Kailer811/r2auto_nav_CDE2310/Mechanical Engineering/Screenshots/6264577846013529998.jpg

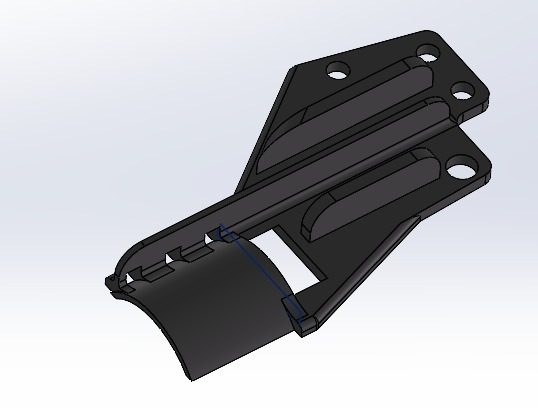
Mechanical Engineering/Screenshots/6264577846013529998.jpg
