Kailer811/r2auto_nav_CDE2310/Electrical Design/Schematic_Diagram_for_Electrical_Design.png

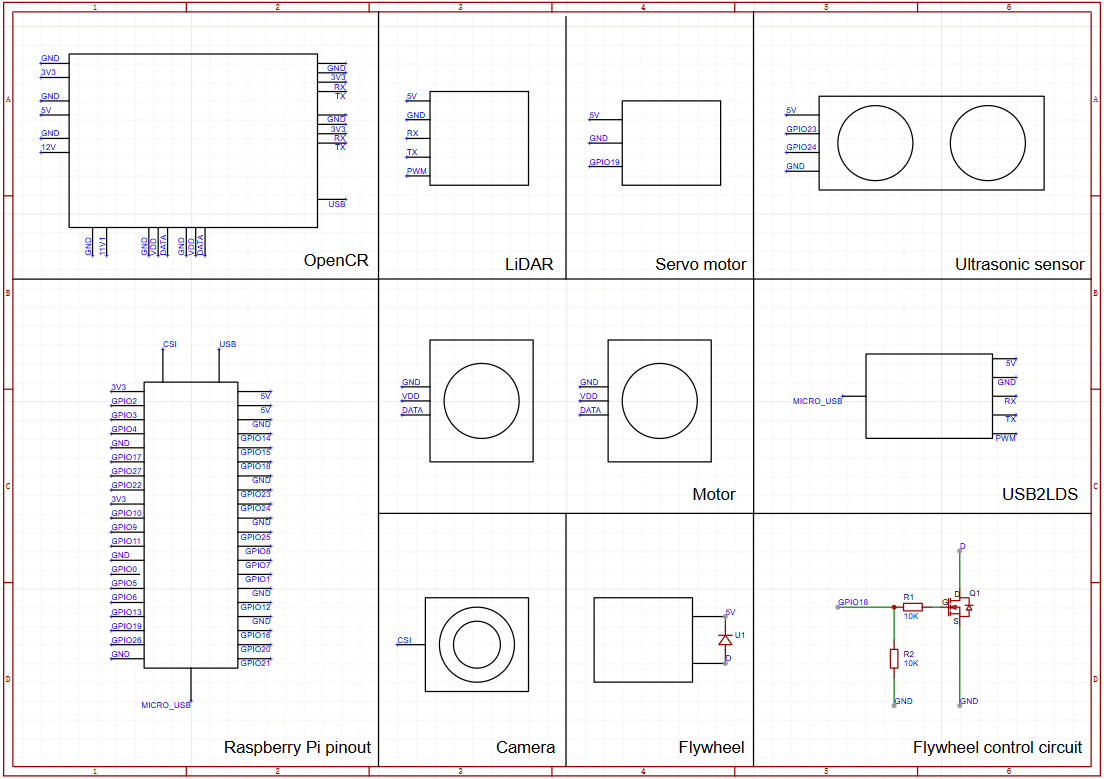
Electrical Design/Schematic_Diagram_for_Electrical_Design.png
