Kailer811/r2auto_nav_CDE2310/Mechanical Engineering/CAD/4MB-3R V4/TurtleBot3 4MB-3R.JPG

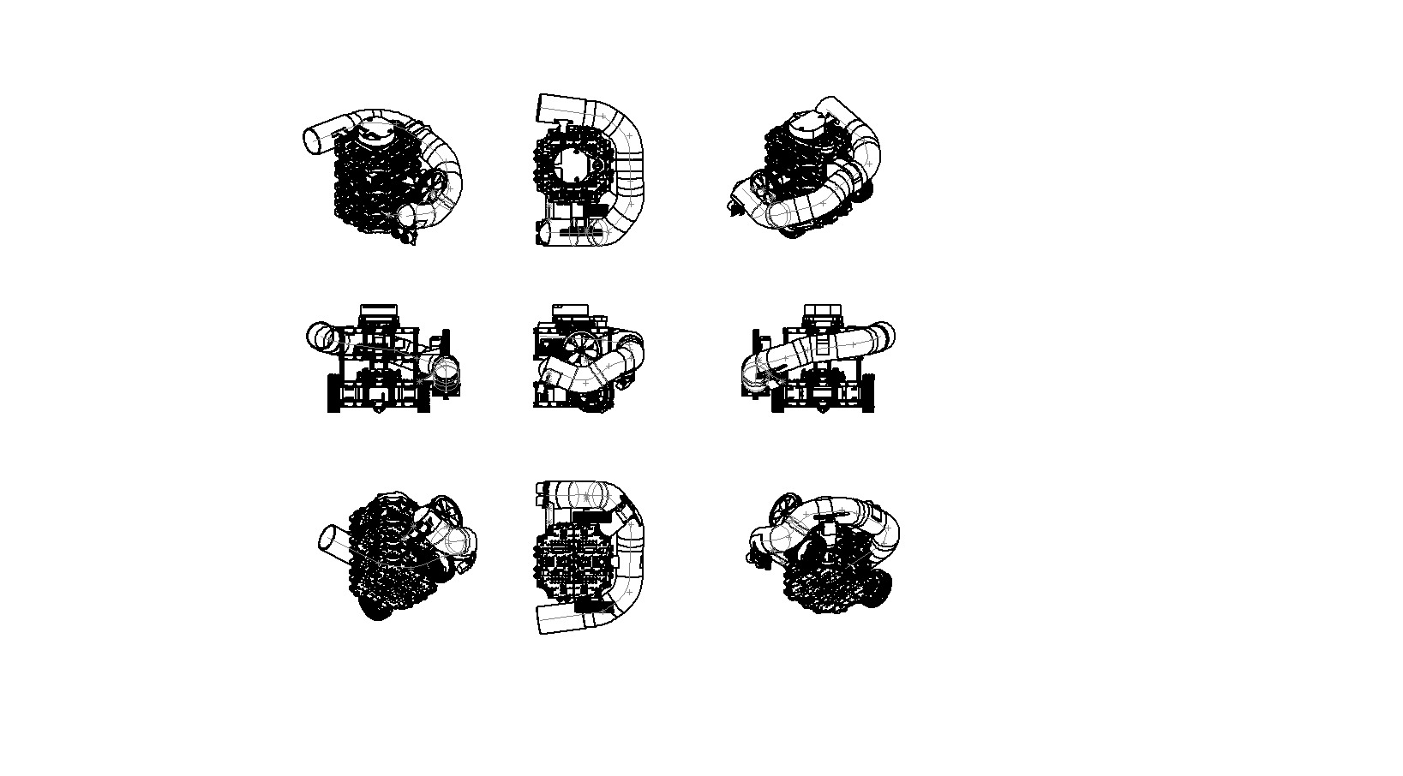
Mechanical Engineering/CAD/4MB-3R V4/TurtleBot3 4MB-3R.JPG
