Kailer811/r2auto_nav_CDE2310/Mechanical Engineering/Screenshots/1.png

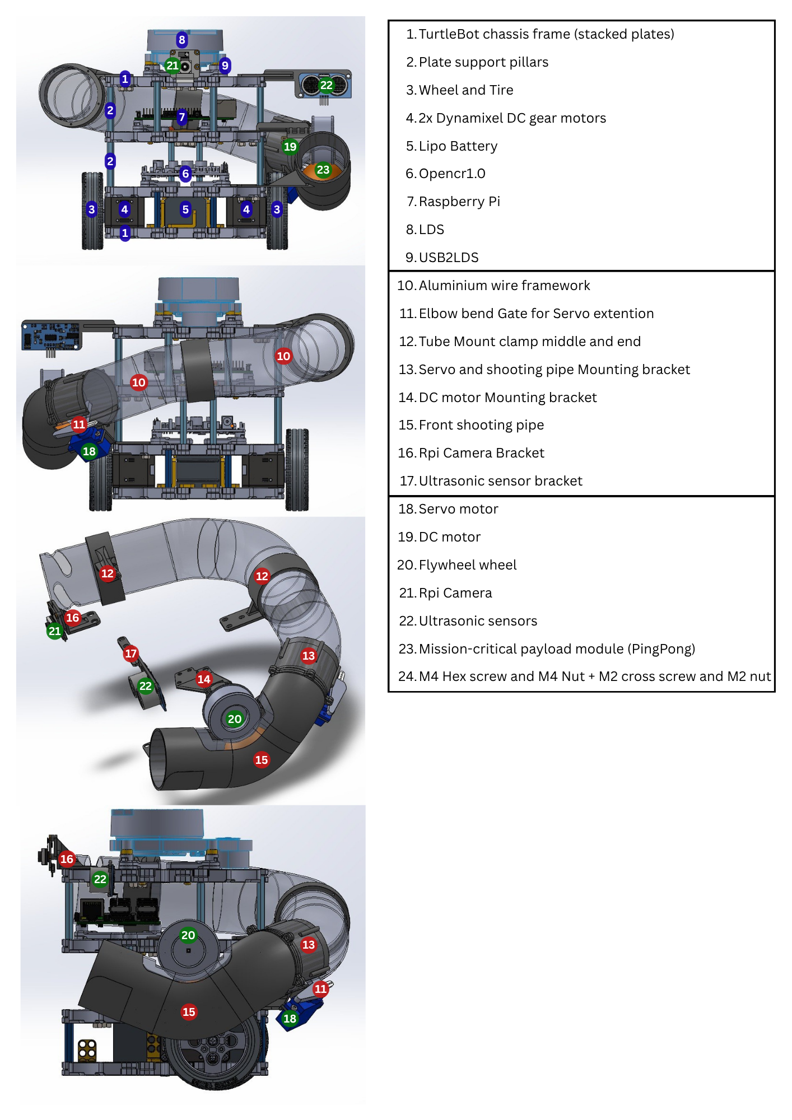
Mechanical Engineering/Screenshots/1.png
