Kailer811/r2auto_nav_CDE2310/Mechanical Engineering/Screenshots/6226596316343635498.jpg

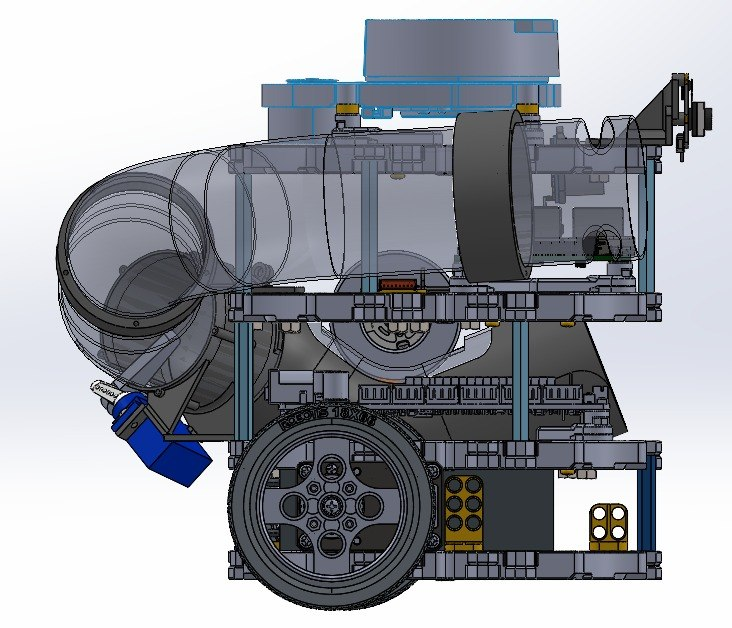
Mechanical Engineering/Screenshots/6226596316343635498.jpg
