Kailer811/r2auto_nav_CDE2310/Mechanical Engineering/CAD/4MB-3R V4/battery-holder-4xaa-1.snapshot.1/Batterie nel portabatterie.SLDASM

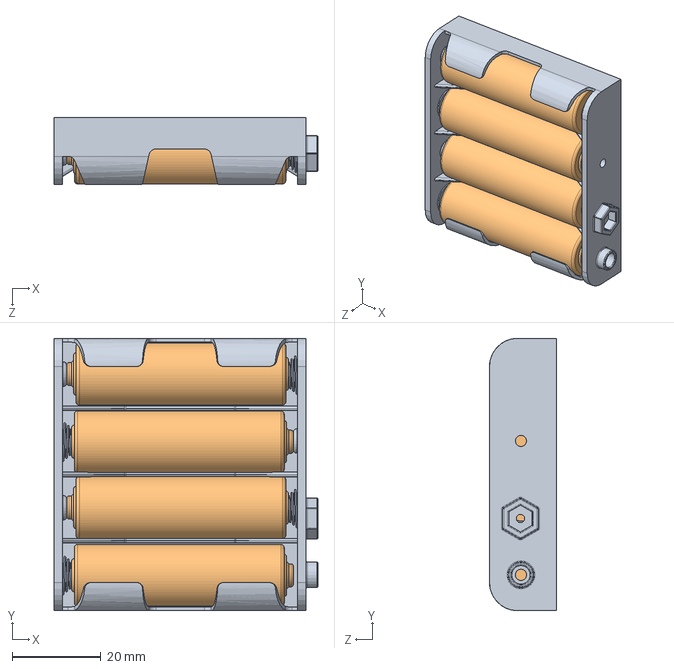
[picture p36: CAD file, 2026-04-19]
Mechanical Engineering/CAD/4MB-3R V4/battery-holder-4xaa-1.snapshot.1/Batterie nel portabatterie.SLDASM
59.6 x 61.5 x 15.1 mm
User Library-R6_AA_UM3-1_5V_holder4AA
Batteria ricaricabile stilo x 4
