Kailer811/r2auto_nav_CDE2310/Mechanical Engineering/3D Printed Parts Files/To be printed V4/Bracket for DC Motor^TurtleBot3 4MB-3R.STL

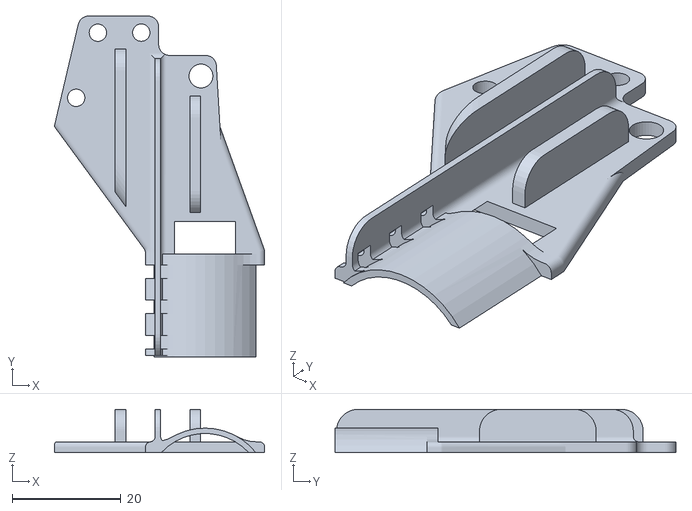
[picture p37: CAD file, 2026-04-08]
Mechanical Engineering/3D Printed Parts Files/To be printed V4/Bracket for DC Motor^TurtleBot3 4MB-3R.STL
38.8 x 62.9 x 8.00
