Kailer811/r2auto_nav_CDE2310/Mechanical Engineering/3D Printed Parts Files/To be printed V4/Bracket1 for Pipe^TurtleBot3 4MB-3R.STL

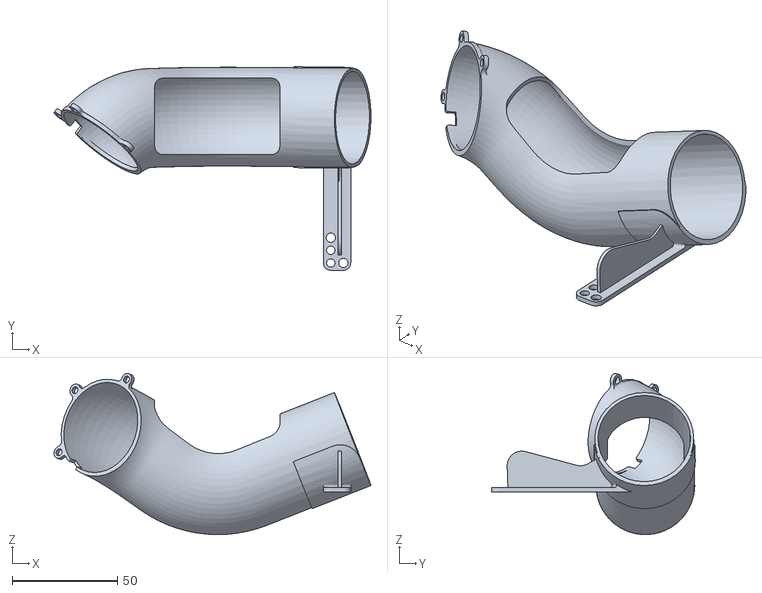
[picture p38: CAD file, 2026-04-08]
Mechanical Engineering/3D Printed Parts Files/To be printed V4/Bracket1 for Pipe^TurtleBot3 4MB-3R.STL
150.6 x 96.8 x 76.6
