Kailer811/r2auto_nav_CDE2310/Mechanical Engineering/3D Printed Parts Files/To be printed V4/Brackets for servo^TurtleBot3 4MB-3R.STL

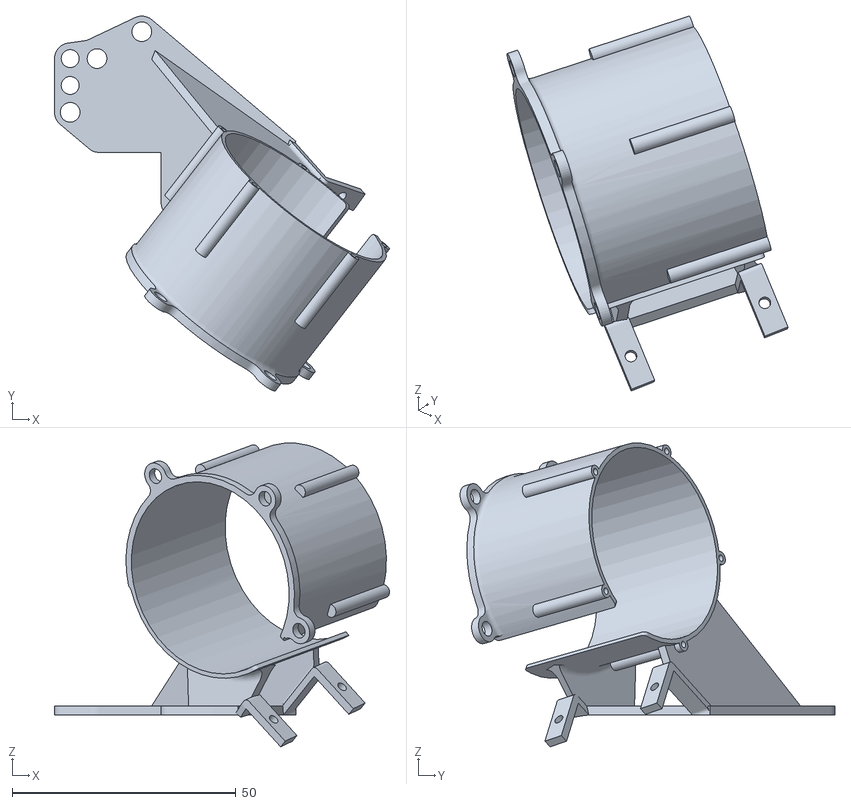
[picture p40: CAD file, 2026-04-08]
Mechanical Engineering/3D Printed Parts Files/To be printed V4/Brackets for servo^TurtleBot3 4MB-3R.STL
74.8 x 83.7 x 67.8
