Kailer811/r2auto_nav_CDE2310/Mechanical Engineering/CAD/4MB-3R V4/battery-holder-4xaa-1.snapshot.1/Batteria ricaricabile stilo.SLDPRT

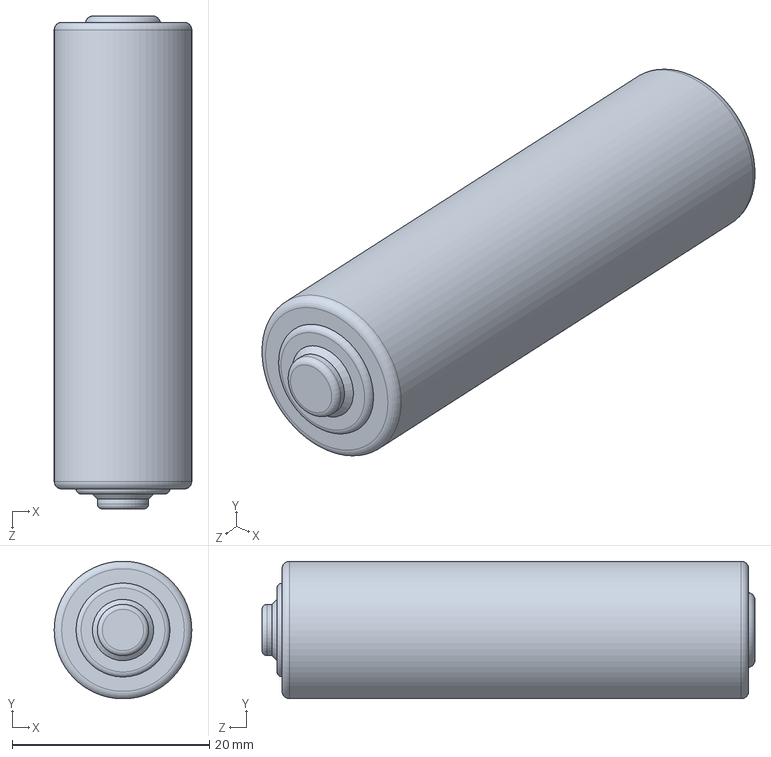
[picture p41: CAD file, 2026-04-19]
Mechanical Engineering/CAD/4MB-3R V4/battery-holder-4xaa-1.snapshot.1/Batteria ricaricabile stilo.SLDPRT
14.0 x 14.0 x 50.0 mm
