Kailer811/r2auto_nav_CDE2310/(list of files, cad)

Other CAD files:
Mechanical Engineering/CAD/4MB-3R V4/LDS _1_.SLDASM
Mechanical Engineering/CAD/4MB-3R V4/Third Floor _1_.SLDASM
Mechanical Engineering/CAD/4MB-3R V4/Forth Floor _1_.SLDASM
Mechanical Engineering/CAD/4MB-3R V4/ball_caster.SLDASM
Mechanical Engineering/CAD/4MB-3R V4/wheel _2_.SLDASM
Mechanical Engineering/CAD/4MB-3R V4/connected plates _1_-3.SLDASM
Mechanical Engineering/CAD/4MB-3R V4/USB2LDS _1_.SLDASM
Mechanical Engineering/CAD/4MB-3R V4/ball_caster _1_.SLDASM
Mechanical Engineering/CAD/4MB-3R V4/wheel _1_.SLDASM
Mechanical Engineering/CAD/4MB-3R V4/connected plates _1_.SLDASM
Mechanical Engineering/CAD/4MB-3R V4/Second Floor _1_.SLDASM
Mechanical Engineering/CAD/4MB-3R V4/OPENCR _1_.SLDASM
Mechanical Engineering/CAD/4MB-3R V4/LDS _1_2.SLDASM
Mechanical Engineering/CAD/4MB-3R V4/First Floor _1_.SLDASM
Mechanical Engineering/CAD/4MB-3R V4/connected plates _1_-2.SLDASM
Mechanical Engineering/CAD/4MB-3R V4/connected plates _1_-1.SLDASM
Mechanical Engineering/CAD/4MB-3R V4/SUPPORT_HEX_M3_0XL45_FF.SLDPRT
Mechanical Engineering/CAD/4MB-3R V4/LB-012.SLDPRT
Mechanical Engineering/CAD/4MB-3R V4/SUPPORT_HEX_M3_0XL20_FF.SLDPRT
Mechanical Engineering/CAD/4MB-3R V4/MANIFOLD_SOLID_BREP_33278.SLDPRT
Mechanical Engineering/CAD/4MB-3R V4/PR16_A01_TIRE_2.SLDPRT
Mechanical Engineering/CAD/4MB-3R V4/USER_LIBRARY-8-VSON_5X6_U-33209.SLDPRT
Mechanical Engineering/CAD/4MB-3R V4/Part 1-1.SLDPRT
Mechanical Engineering/CAD/4MB-3R V4/Part 28.SLDPRT
Mechanical Engineering/CAD/4MB-3R V4/_____-________1-33165.SLDPRT
Mechanical Engineering/CAD/4MB-3R V4/1-33193.SLDPRT
Mechanical Engineering/CAD/4MB-3R V4/PHS_M2_5X12.SLDPRT
Mechanical Engineering/CAD/4MB-3R V4/50MIL_HEADER_BODY-33251.SLDPRT
Mechanical Engineering/CAD/4MB-3R V4/PIN-33297.SLDPRT
Mechanical Engineering/CAD/4MB-3R V4/USER_LIBRARY-WE-DD-L_PIN_-33142.SLDPRT
Mechanical Engineering/CAD/4MB-3R V4/MANIFOLD_SOLID_BREP_33099.SLDPRT
Mechanical Engineering/CAD/4MB-3R V4/PR30_IBB_01_3D.SLDPRT
Mechanical Engineering/CAD/4MB-3R V4/_______-________3-33139.SLDPRT
Mechanical Engineering/CAD/4MB-3R V4/MANIFOLD_SOLID_BREP_33236.SLDPRT
Mechanical Engineering/CAD/4MB-3R V4/MANIFOLD_SOLID_BREP_33072.SLDPRT
Mechanical Engineering/CAD/4MB-3R V4/MANIFOLD_SOLID_BREP_33056.SLDPRT
Mechanical Engineering/CAD/4MB-3R V4/MANIFOLD_SOLID_BREP_33227.SLDPRT
Mechanical Engineering/CAD/4MB-3R V4/BIC04_C01_PCB.SLDPRT
Mechanical Engineering/CAD/4MB-3R V4/Part 25.SLDPRT
Mechanical Engineering/CAD/4MB-3R V4/_______-________2_4_-33270.SLDPRT
Mechanical Engineering/CAD/4MB-3R V4/3-33196.SLDPRT
Mechanical Engineering/CAD/4MB-3R V4/Part 5.SLDPRT
Mechanical Engineering/CAD/4MB-3R V4/MANIFOLD_SOLID_BREP_33098.SLDPRT
Mechanical Engineering/CAD/4MB-3R V4/MANIFOLD_SOLID_BREP_33259.SLDPRT
Mechanical Engineering/CAD/4MB-3R V4/MANIFOLD_SOLID_BREP_33095.SLDPRT
Mechanical Engineering/CAD/4MB-3R V4/RADYUS2.SLDPRT
Mechanical Engineering/CAD/4MB-3R V4/2-33170.SLDPRT
Mechanical Engineering/CAD/4MB-3R V4/SAR1.SLDPRT
Mechanical Engineering/CAD/4MB-3R V4/PIN-33287.SLDPRT
Mechanical Engineering/CAD/4MB-3R V4/Surface 3.SLDPRT
Mechanical Engineering/CAD/4MB-3R V4/MANIFOLD_SOLID_BREP_33082.SLDPRT
Mechanical Engineering/CAD/4MB-3R V4/PR30_IBB_01_3D-1.SLDPRT
Mechanical Engineering/CAD/4MB-3R V4/_____-________1-33216.SLDPRT
Mechanical Engineering/CAD/4MB-3R V4/MANIFOLD_SOLID_BREP_33071.SLDPRT
Mechanical Engineering/CAD/4MB-3R V4/MANIFOLD_SOLID_BREP_33092.SLDPRT
Mechanical Engineering/CAD/4MB-3R V4/USER_LIBRARY-WE-DD-L_DECKEL_2.SLDPRT
Mechanical Engineering/CAD/4MB-3R V4/USER_LIBRARY-8-VSON_5X6_U-33202.SLDPRT
Mechanical Engineering/CAD/4MB-3R V4/MANIFOLD_SOLID_BREP_33059.SLDPRT
Mechanical Engineering/CAD/4MB-3R V4/Part 20.SLDPRT
Mechanical Engineering/CAD/4MB-3R V4/MANIFOLD_SOLID_BREP_33253.SLDPRT
Mechanical Engineering/CAD/4MB-3R V4/Part 4.SLDPRT
Mechanical Engineering/CAD/4MB-3R V4/MANIFOLD_SOLID_BREP_33041.SLDPRT
Mechanical Engineering/CAD/4MB-3R V4/PIN-33249.SLDPRT
Mechanical Engineering/CAD/4MB-3R V4/USER_LIBRARY-8-VSON_5X6_U-33109.SLDPRT
Mechanical Engineering/CAD/4MB-3R V4/50MIL_HEADER_BODY-33294.SLDPRT
Mechanical Engineering/CAD/4MB-3R V4/MANIFOLD_SOLID_BREP_33055.SLDPRT
Mechanical Engineering/CAD/4MB-3R V4/MANIFOLD_SOLID_BREP_33284.SLDPRT
Mechanical Engineering/CAD/4MB-3R V4/50MIL_HEADER_BODY-33296.SLDPRT
Mechanical Engineering/CAD/4MB-3R V4/_______-________2_3_-33137.SLDPRT
Mechanical Engineering/CAD/4MB-3R V4/MANIFOLD_SOLID_BREP_33053.SLDPRT
Mechanical Engineering/CAD/4MB-3R V4/Part 8.SLDPRT
Mechanical Engineering/CAD/4MB-3R V4/_______-________2_4_-33138.SLDPRT
Mechanical Engineering/CAD/4MB-3R V4/MANIFOLD_SOLID_BREP_33168.SLDPRT
Mechanical Engineering/CAD/4MB-3R V4/Surface 12.SLDPRT
Mechanical Engineering/CAD/4MB-3R V4/MANIFOLD_SOLID_BREP_33163.SLDPRT
Mechanical Engineering/CAD/4MB-3R V4/PIN-33235.SLDPRT
Mechanical Engineering/CAD/4MB-3R V4/P30_ISP_A001_3D.SLDPRT
Mechanical Engineering/CAD/4MB-3R V4/MANIFOLD_SOLID_BREP_33060.SLDPRT
Mechanical Engineering/CAD/4MB-3R V4/Surface 24.SLDPRT
Mechanical Engineering/CAD/4MB-3R V4/_______-________2_2_-33268.SLDPRT
Mechanical Engineering/CAD/4MB-3R V4/MANIFOLD_SOLID_BREP_33262.SLDPRT
Mechanical Engineering/CAD/4MB-3R V4/MANIFOLD_SOLID_BREP_33115.SLDPRT
Mechanical Engineering/CAD/4MB-3R V4/3-33166.SLDPRT
Mechanical Engineering/CAD/4MB-3R V4/MANIFOLD_SOLID_BREP_33239.SLDPRT
Mechanical Engineering/CAD/4MB-3R V4/MANIFOLD_SOLID_BREP_33077.SLDPRT
Mechanical Engineering/CAD/4MB-3R V4/MANIFOLD_SOLID_BREP_33265.SLDPRT
Mechanical Engineering/CAD/4MB-3R V4/MANIFOLD_SOLID_BREP_33260.SLDPRT
Mechanical Engineering/CAD/4MB-3R V4/LUSTRO1.SLDPRT
Mechanical Engineering/CAD/4MB-3R V4/MANIFOLD_SOLID_BREP_33047.SLDPRT
Mechanical Engineering/CAD/4MB-3R V4/MANIFOLD_SOLID_BREP_33258.SLDPRT
Mechanical Engineering/CAD/4MB-3R V4/Surface 13.SLDPRT
Mechanical Engineering/CAD/4MB-3R V4/MANIFOLD_SOLID_BREP_33123.SLDPRT
Mechanical Engineering/CAD/4MB-3R V4/USER_LIBRARY-8-VSON_5X6_U-33106.SLDPRT
Mechanical Engineering/CAD/4MB-3R V4/MANIFOLD_SOLID_BREP_33100.SLDPRT
Mechanical Engineering/CAD/4MB-3R V4/Surface 5.SLDPRT
Mechanical Engineering/CAD/4MB-3R V4/MANIFOLD_SOLID_BREP_33282.SLDPRT
Mechanical Engineering/CAD/4MB-3R V4/SUPPORT_HEX_M3_0XL35_FF.SLDPRT
Mechanical Engineering/CAD/4MB-3R V4/Part 22.SLDPRT
Mechanical Engineering/CAD/4MB-3R V4/MANIFOLD_SOLID_BREP_33286.SLDPRT
Mechanical Engineering/CAD/4MB-3R V4/MANIFOLD_SOLID_BREP_33285.SLDPRT
Mechanical Engineering/CAD/4MB-3R V4/Surface 22.SLDPRT
Mechanical Engineering/CAD/4MB-3R V4/USER_LIBRARY-8-VSON_5X6_U-33108.SLDPRT
Mechanical Engineering/CAD/4MB-3R V4/MANIFOLD_SOLID_BREP_33068.SLDPRT
Mechanical Engineering/CAD/4MB-3R V4/MANIFOLD_SOLID_BREP_33203.SLDPRT
Mechanical Engineering/CAD/4MB-3R V4/Surface 26.SLDPRT
Mechanical Engineering/CAD/4MB-3R V4/MANIFOLD_SOLID_BREP_33089.SLDPRT
Mechanical Engineering/CAD/4MB-3R V4/MANIFOLD_SOLID_BREP_33280.SLDPRT
Mechanical Engineering/CAD/4MB-3R V4/_______-________8-33241.SLDPRT
Mechanical Engineering/CAD/4MB-3R V4/Part 10.SLDPRT
Mechanical Engineering/CAD/4MB-3R V4/MANIFOLD_SOLID_BREP_33049.SLDPRT
Mechanical Engineering/CAD/4MB-3R V4/MANIFOLD_SOLID_BREP_33102.SLDPRT
Mechanical Engineering/CAD/4MB-3R V4/MANIFOLD_SOLID_BREP_33058.SLDPRT
Mechanical Engineering/CAD/4MB-3R V4/USER_LIBRARY-8-VSON_5X6_U-33219.SLDPRT
Mechanical Engineering/CAD/4MB-3R V4/MANIFOLD_SOLID_BREP_33076.SLDPRT
Mechanical Engineering/CAD/4MB-3R V4/IMPORTED1-33207.SLDPRT
Mechanical Engineering/CAD/4MB-3R V4/3-33245.SLDPRT
Mechanical Engineering/CAD/4MB-3R V4/Part 26.SLDPRT
Mechanical Engineering/CAD/4MB-3R V4/Surface 34.SLDPRT
Mechanical Engineering/CAD/4MB-3R V4/MANIFOLD_SOLID_BREP_33254.SLDPRT
Mechanical Engineering/CAD/4MB-3R V4/Surface 28.SLDPRT
Mechanical Engineering/CAD/4MB-3R V4/MANIFOLD_SOLID_BREP_33114.SLDPRT
Mechanical Engineering/CAD/4MB-3R V4/MANIFOLD_SOLID_BREP_33044.SLDPRT
Mechanical Engineering/CAD/4MB-3R V4/MANIFOLD_SOLID_BREP_33070.SLDPRT
Mechanical Engineering/CAD/4MB-3R V4/MANIFOLD_SOLID_BREP_33122.SLDPRT
Mechanical Engineering/CAD/4MB-3R V4/MANIFOLD_SOLID_BREP_33075.SLDPRT
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
