Kailer811/r2auto_nav_CDE2310/Mechanical Engineering/Assembly Drawing/Assembly Deawing V4 4MB3R with Dimensions.pdf

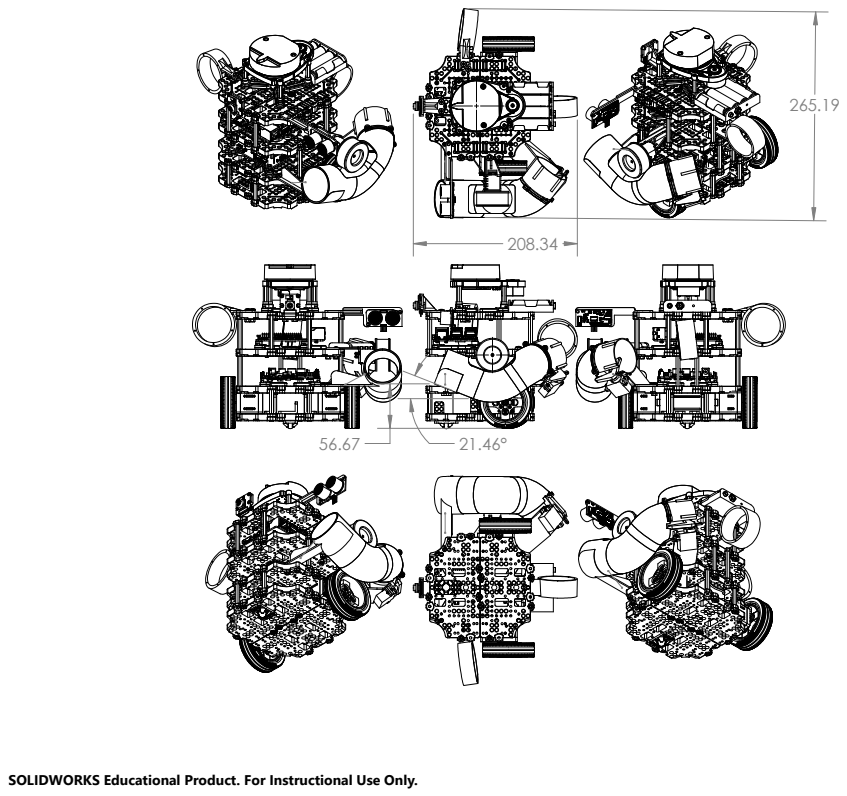
[picture p43: page 1]

SOLIDWORKS Educational Product. For Instructional Use Only.
