Kailer811/r2auto_nav_CDE2310/Mechanical Engineering/Assembly Drawing/Assembly Drawing V3 4MB3R.pdf

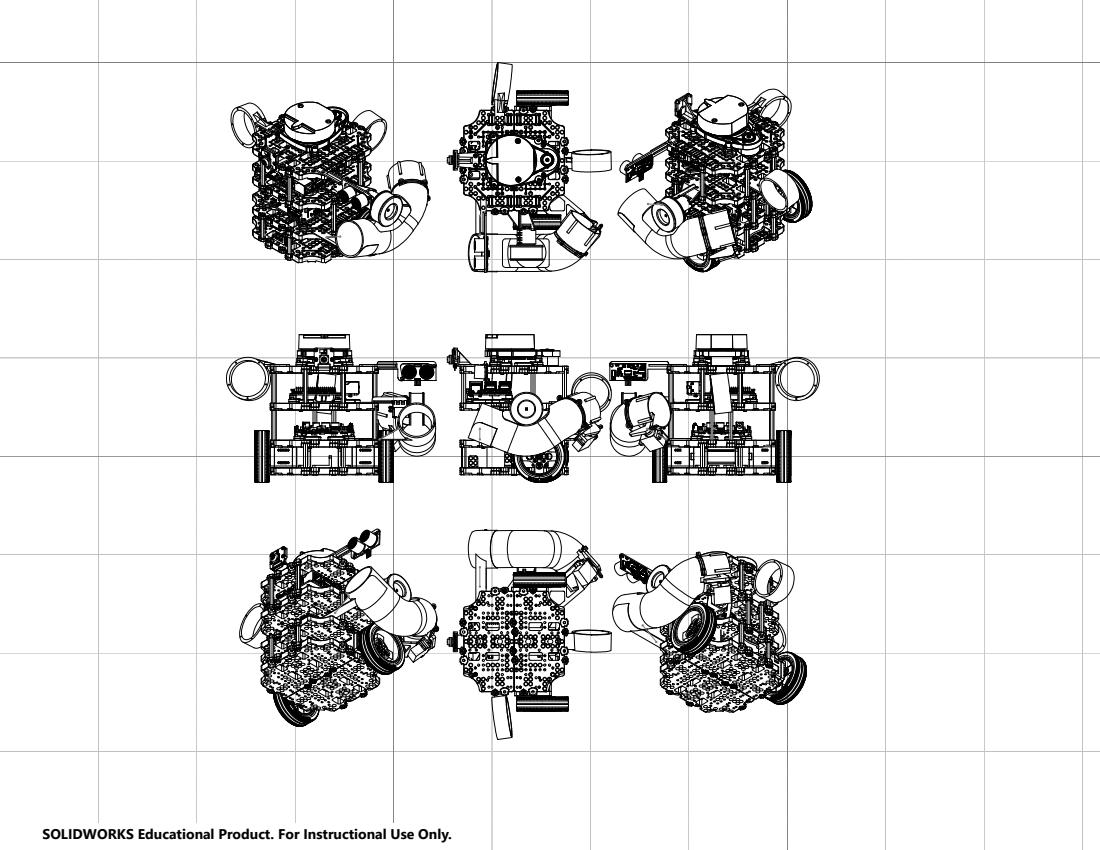
[picture p44: page 1]

SOLIDWORKS Educational Product. For Instructional Use Only.
