Kailer811/r2auto_nav_CDE2310/(commit log)

2026-03-31 Added CAD drawings
    [022035025.SLDPRT, 1-33154.SLDPRT, 1-33162.SLDPRT, 1-33193.SLDPRT, 1-33242.SLDPRT, 2-33160.SLDPRT, 2-33170.SLDPRT, 2-33199.SLDPRT]
2026-03-31 fixed auto_nav and aruco stuff
    [servo_motor_run.py]
2026-04-02 BUGFIX: missing bracket, additional logs
2026-04-08 added CAD prototypes
    [022035025.SLDPRT, 1-33154.SLDPRT, 1-33162.SLDPRT, 1-33193.SLDPRT, 1-33242.SLDPRT, 2-33160.SLDPRT, 2-33170.SLDPRT, 2-33199.SLDPRT]
2026-04-08 removed old files
    [022035025.SLDPRT, 1-33154.SLDPRT, 1-33162.SLDPRT, 1-33193.SLDPRT, 1-33242.SLDPRT, 2-33160.SLDPRT, 2-33170.SLDPRT, 2-33199.SLDPRT]
2026-04-08 vibe coded pid
2026-04-14 changed ros2 camera 2 to be wrt to cam
2026-04-14 tried changing nav and broke it
    [ros2_nav.py]
2026-04-15 tried making PID better didnt work
2026-04-19 feat: add a schematic diagram
2026-04-19 Rename Schematic Diagram for Electrical Design.png to Schematic_Diagram_for_Electrical_Design.png
2026-04-19 CAD V4 Added
    [022035025.SLDPRT, 1-33154.SLDPRT, 1-33162.SLDPRT, 1-33193.SLDPRT, 1-33242.SLDPRT, 2-33160.SLDPRT, 2-33170.SLDPRT, 2-33199.SLDPRT]
2026-04-19 Organization + New Assembly + CAD V4 + BOM V4
    [022035025.SLDPRT, 1-33154.SLDPRT, 1-33162.SLDPRT, 1-33193.SLDPRT, 1-33242.SLDPRT, 1_5V_holder4AA.x_t, 2-33160.SLDPRT, 2-33170.SLDPRT]
